nelfy22/FAIR-Battery/docs_overpotential/README.md

# Welcome to the Overflower Team
This project contributes to the characterization and measurement of our Redox Flow Battery, specifically the overpotential.
The existence of overpotential means less energy is recovered than thermodynamics predicts.
Measuring the overpotential is directly related to the voltage efficiency of the battery.
Our current hardware design supports any type of battery up to about 4V.

## How do we do it?
We will initiate this project by creating program and setting up the electronic instruments to measure voltage and capacity 
of an existing rechargeable battery.
By using the measurement procedure made by V. Pop et al., we measure the overpotential of the battery.
After the program works and measurements are successful, we will apply it to our flow battery.

## How to contribute
This project is currently on hold. You are encouraged to fork it and improve it. If you want to reach out for support, create an issue or visit this project on [JOGL](https://app.jogl.io/project/853).

## License
© 2021 Nelfyenny and Sjoerd Seinhorst. All work in this folder is licensed under a [Creative Commons Attribution-ShareAlike 4.0 International License](http://creativecommons.org/licenses/by-sa/4.0/). A copy may also be found in the [LICENSE.md](LICENSE.md) file.

## Source
V. Pop et al. (2008) _Battery Management Systems. Accurate State-of-Charge Indication for Battery-Powered Applications._
doi: [10.1007/978-1-4020-6945-1_4](https://doi.org/10.1007/978-1-4020-6945-1_4)
