nelfy22/FAIR-Battery/docs_overpotential/img/AD2.png

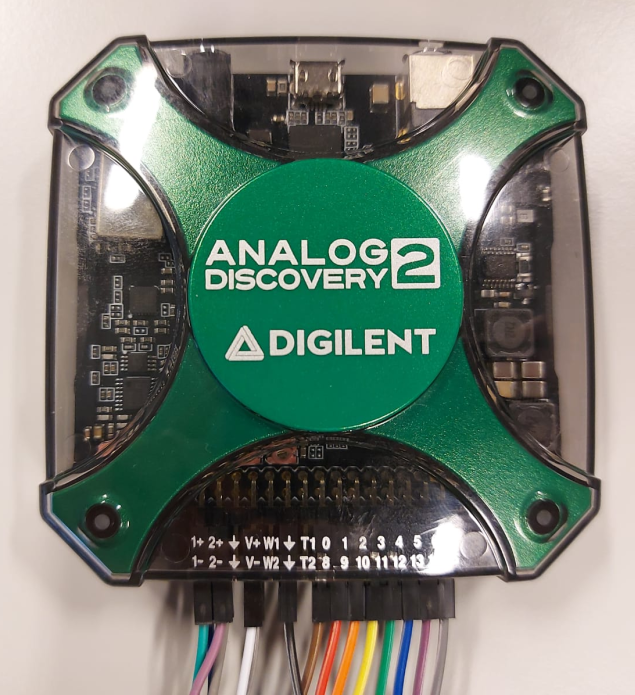
docs_overpotential/img/AD2.png
