nelfy22/FAIR-Battery/docs_overpotential/img/Adaptor_Connection.png

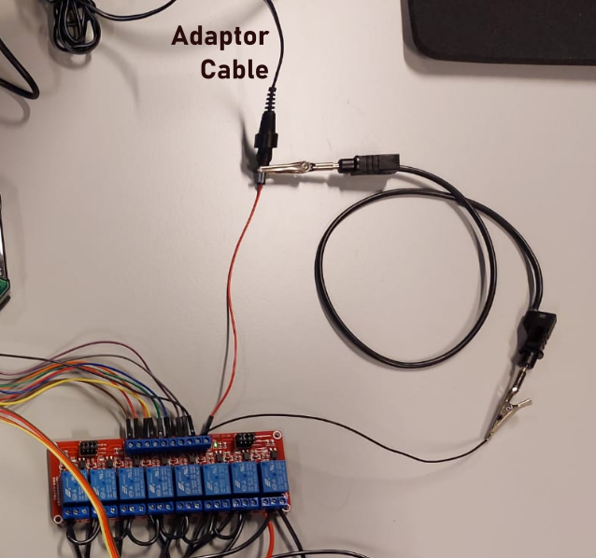
docs_overpotential/img/Adaptor_Connection.png
