nelfy22/FAIR-Battery/docs_overpotential/img/Circuit_Full.jpg

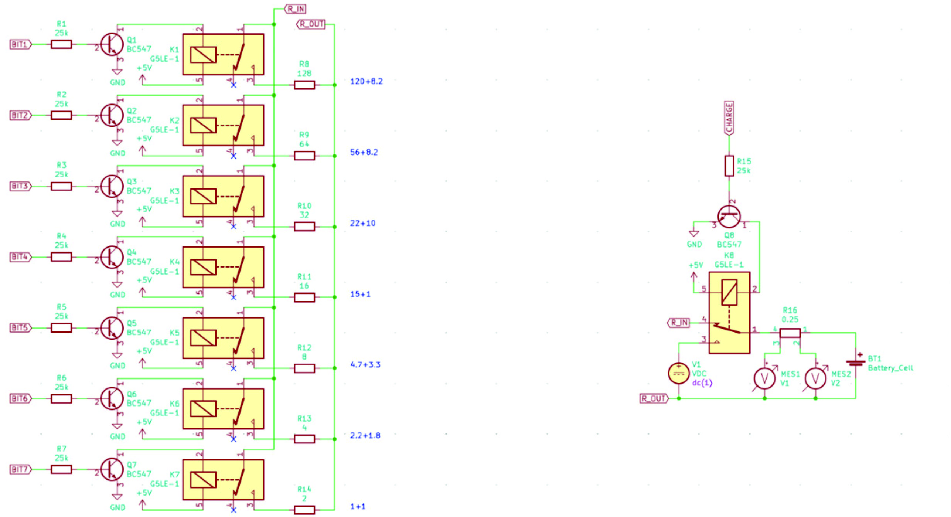
docs_overpotential/img/Circuit_Full.jpg
