nelfy22/FAIR-Battery/docs_overpotential/img/Hardware.jpg

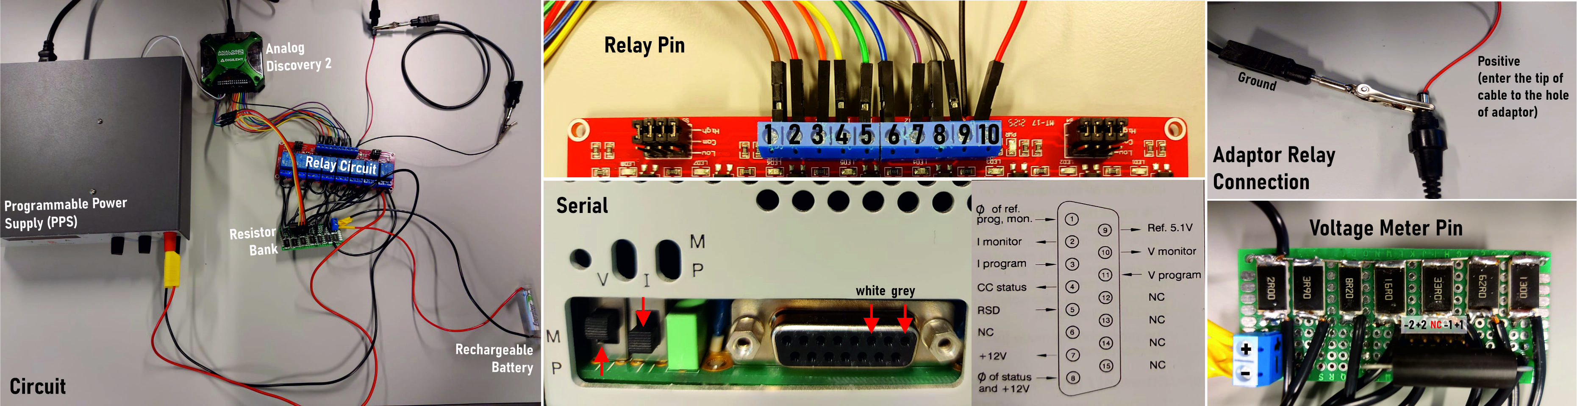
docs_overpotential/img/Hardware.jpg
