nelfy22/FAIR-Battery/docs_overpotential/img/Red_Cable_PPS.jpeg

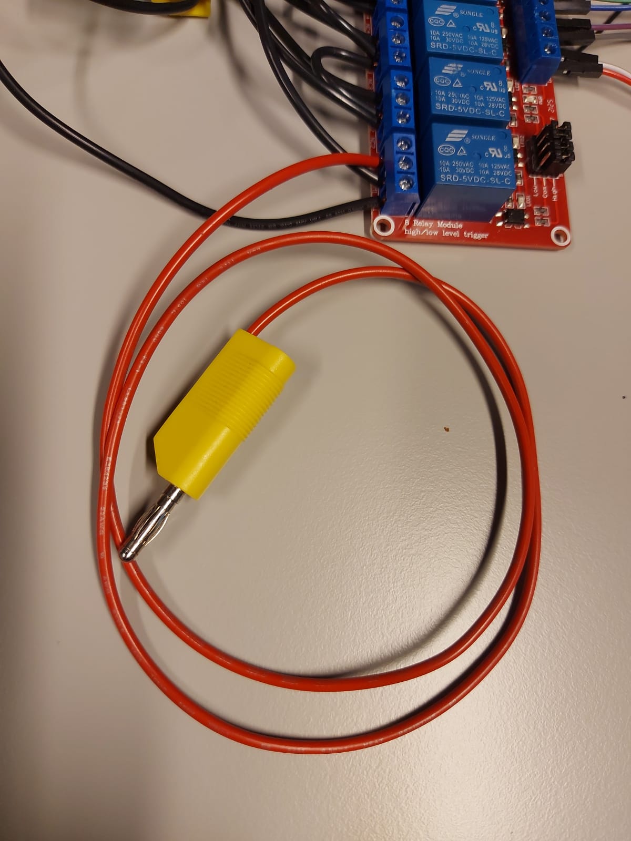
docs_overpotential/img/Red_Cable_PPS.jpeg
