nelfy22/FAIR-Battery/docs_overpotential/img/Relay_Circuit.png

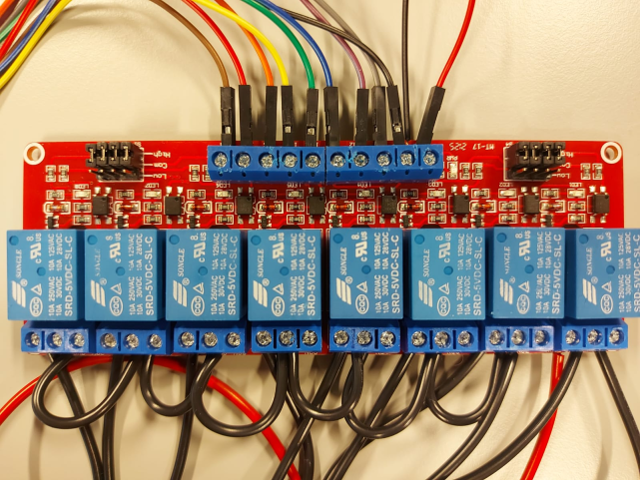
docs_overpotential/img/Relay_Circuit.png
