nelfy22/FAIR-Battery/docs_overpotential/img/Relay_Pin.png

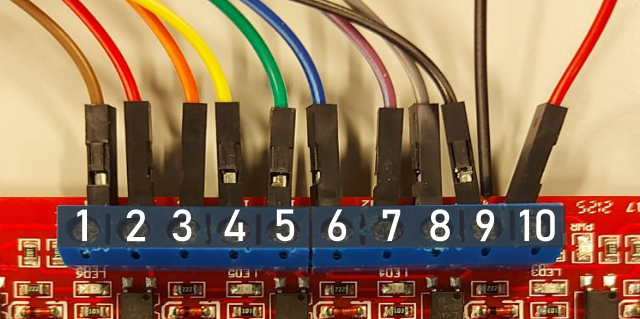
docs_overpotential/img/Relay_Pin.png
