nelfy22/FAIR-Battery/docs_overpotential/img/Resistor_Bank.png

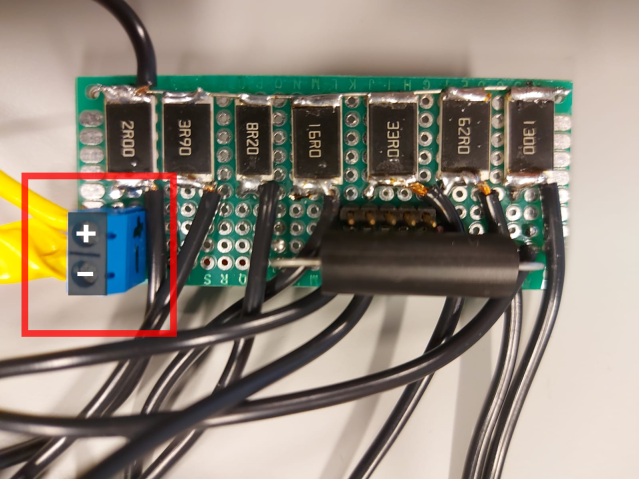
docs_overpotential/img/Resistor_Bank.png
