nelfy22/FAIR-Battery/docs_overpotential/img/Serial.png

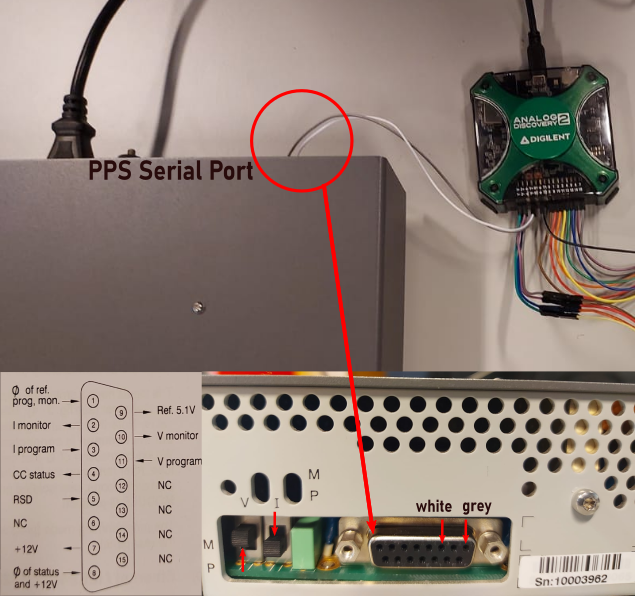
docs_overpotential/img/Serial.png
