nelfy22/FAIR-Battery/docs_overpotential/img/Short.png

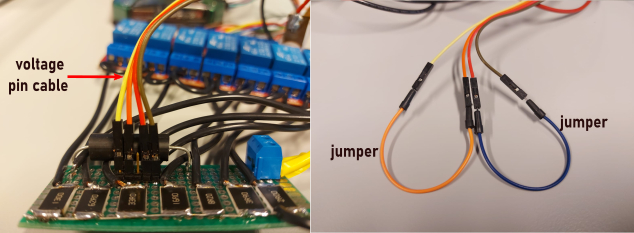
docs_overpotential/img/Short.png
