nelfy22/FAIR-Battery/docs_overpotential/img/Voltage_Pin.png

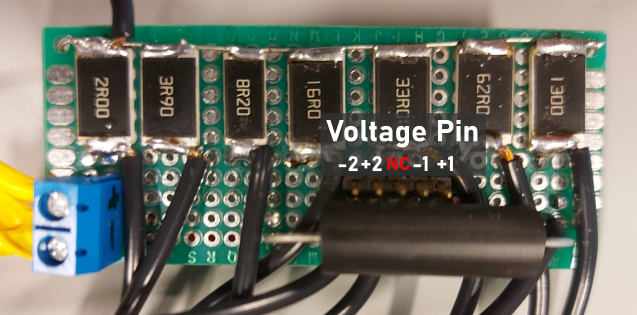
docs_overpotential/img/Voltage_Pin.png
