nelfy22/FAIR-Battery/docs_overpotential/variable_load.sch

## KiCad design docs_overpotential/variable_load.sch (2021-11-11)

Schematic: variable_load.sch

Parts:
BT1: Battery_Cell
K1, K2, K3, K4, K5, K6, K7, K8: G5LE-1; Relay_SPDT_Omron-G5LE-1
MES1: V1
MES2: V2
Q1, Q2, Q3, Q4, Q5, Q6, Q7, Q8: BC547; TO-92_Inline
R1, R2, R3, R4, R5, R6, R7: 25k; R_Axial_DIN0207_L6.3mm_D2.5mm_P10.16mm_Horizontal
R8: 128; R_Axial_DIN0207_L6.3mm_D2.5mm_P10.16mm_Horizontal
R9: 64; R_Axial_DIN0414_L11.9mm_D4.5mm_P20.32mm_Horizontal
R10: 32; R_Axial_DIN0414_L11.9mm_D4.5mm_P20.32mm_Horizontal
R11: 16; R_Axial_Power_L48.0mm_W12.5mm_P55.88mm
R12: 8; R_Axial_Power_L48.0mm_W12.5mm_P55.88mm
R13: 4; R_Axial_Power_L48.0mm_W12.5mm_P55.88mm
R14: 2; R_Axial_Power_L48.0mm_W12.5mm_P55.88mm
R15: 25k
R16: 0.25
V1: VDC

Notes on the sheet:
Parallel resistors 1 - 128 Ohm Step size near 30 Ohm: 25% Step size near 1 Ohm: 0.79% Can be turned off Cannot be short circuited
120+8.2
56+8.2
22+10
15+1
4.7+3.3
2.2+1.8
1+1
