nelfy22/FAIR-Battery/(threads)

Thread 1 (2021-10-25):

[BUG] Mode 1 of overpotential measurement is skipped

sjoerdsein, 2021-10-25:
**Describe the bug**
After the battery discharges in mode 0, it switches to mode 2 instead of mode 1.

**To Reproduce**
Follow the overpotential measurement [instructions](https://git.science.uu.nl/UED2021/Experiment_Design_2021/-/blob/master/subprojects/FlowerPower_SjoerdNelfy/project_instructions.md).
When the battery reaches 1.0 V in mode 0, you will see it jump to mode 2.

**Expected behavior**
When the battery reaches 1.0 V in mode 0, it switches to mode 1 and the voltage goes up slightly. The voltage continues to decay and when it hits 1.0 V again, it switches to mode 2.

**System Information**
	- OS: Linux
	- OS Version: 5.14.14
	- Python Version: 3.9.7
	- Labphew Version: 0.3.3
	- Digilent WaveForms Version: 0.1.2
	- Commit hash: d4790e7

Closed 2021-11-11.

Thread 2 (2021-11-11):

Constant current feedback to adjust load

sjoerdsein, 2021-11-11:
**Is your feature request related to a problem? Please describe.**
Due to the lack of a feedback algorithm, the constant current discharging mode is actually constant resistance.

**Describe the solution you'd like**
With the addition of a feedback algorithm, we can correct for the changing voltage of the battery and adjust the load resistance to keep the current more constant. It should be robust against noise and spikes, not overshoot the target current too much, and be resistant to feedback loops and self-induced oscillations.

Thread 3 (2021-11-11):

Better online SoC estimation algorithm

sjoerdsein, 2021-11-11:
**Is your feature request related to a problem? Please describe.**
Currently we end the charging and discharging cycles when the measured battery voltage, including overpotential, hits 1.5V and 1.0V respectively. This means that at high currents, we end these cycles prematurely.

**Describe the solution you'd like**
An algorithm to estimate the SoC with current flowing, to end charging and discharging when the battery is actually full or empty, should be a major improvement to measurements results. An example of such an algorithm is described [here](https://doi.org/10.1007/978-1-4020-6945-1_4).

**Describe alternatives you've considered**
The current algorithm tries to keep the current constant through the whole charging cycle and also prevent applying too high of a voltage to the battery. That means we need to cut charging early. To reach a higher SoC while not subjecting the battery to a higher voltage, we need to reduce the current supplied to the battery. Then high current charging cannot be done in constant current mode, and the overpotential will reduce for lower charging currents. This is not ideal.
