nelfy22/FAIR-Battery/(commit log)

2021-10-07 Implement resistance bank and add config
2021-10-08 Add code to run basic charge discharge cycles
2021-10-18 Fix not switching after mode 2
2021-11-11 Add overpotential documentation
    [variable_load.sch]
